znicholson17/P-Linked/ESP32_S3_ETH/README.md

# ESP32-S3 Ethernet PCB

The ESP32_S3_ETH KiCad project is a ESP32-S3 based PCB with built in Ethernet.  
The PCB has base features of a base ESP32-S3 Development board but with additional features.  

## Revision 1.0:

### Features
- Built-in 5V and 3.3V test points
- Grounded mounting points
- Programmable over UART and USB
- Wireless and Wired Connectivity
- 2 Programmable RGB LEDs
- Built to same form factor as WisLink LX200V20 EVB

### Hardware
  - ESP32-S3-WROOM-1-N16R8
  - QFN28 USB to UART Bridge
  - WizNet W5500 Ethernet Controller
  - 25Mhz Crystal Oscillators

### PCB
The first image shows the overall layout of the PCB with fills hidden and for each corresponding 3D View image, there is a built PCB image shown below.  

#### Layout of PCB
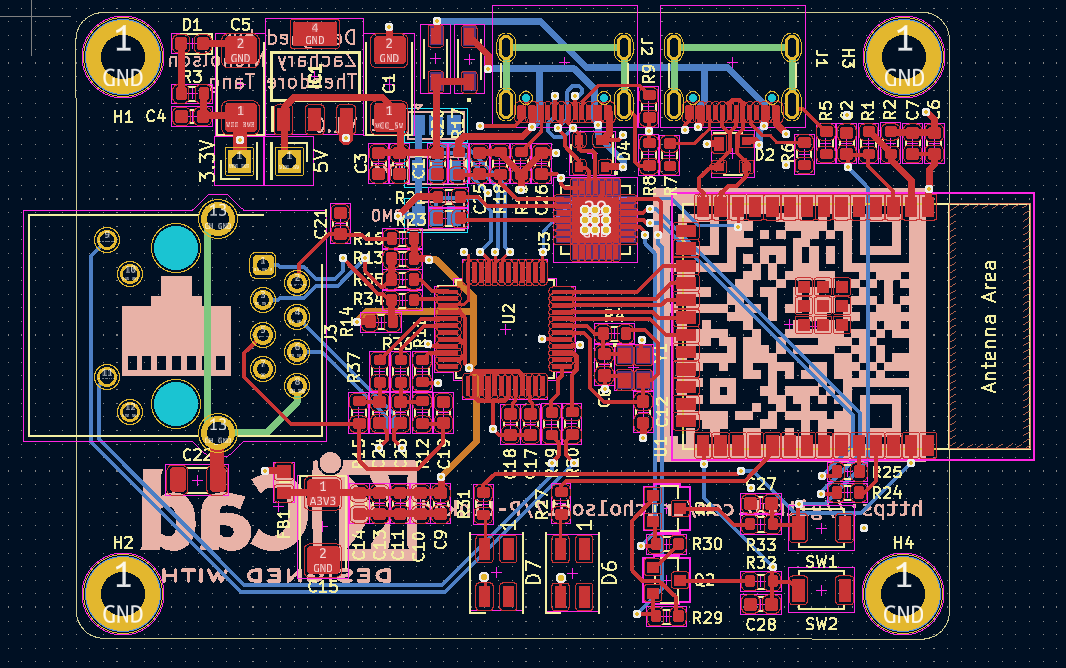
[picture p2: Docs/Images/ESP32-S3_ETH_LAYOUT.png]
  

#### Front of PCB

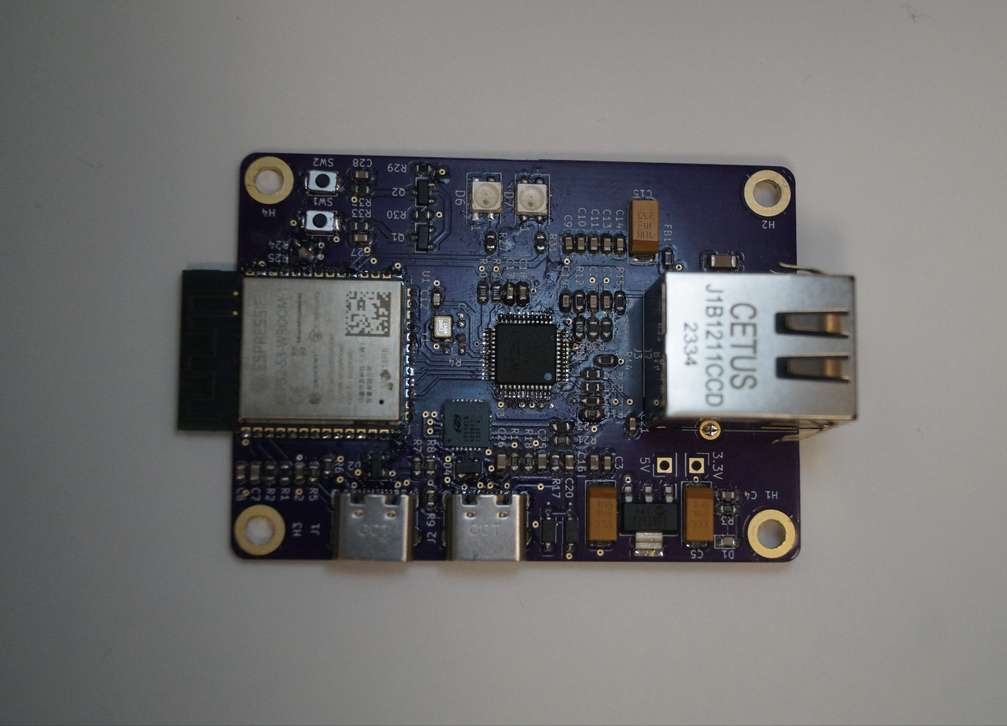
[picture p3: Docs/Images/ESP32-S3_ETH_FRONT.png]

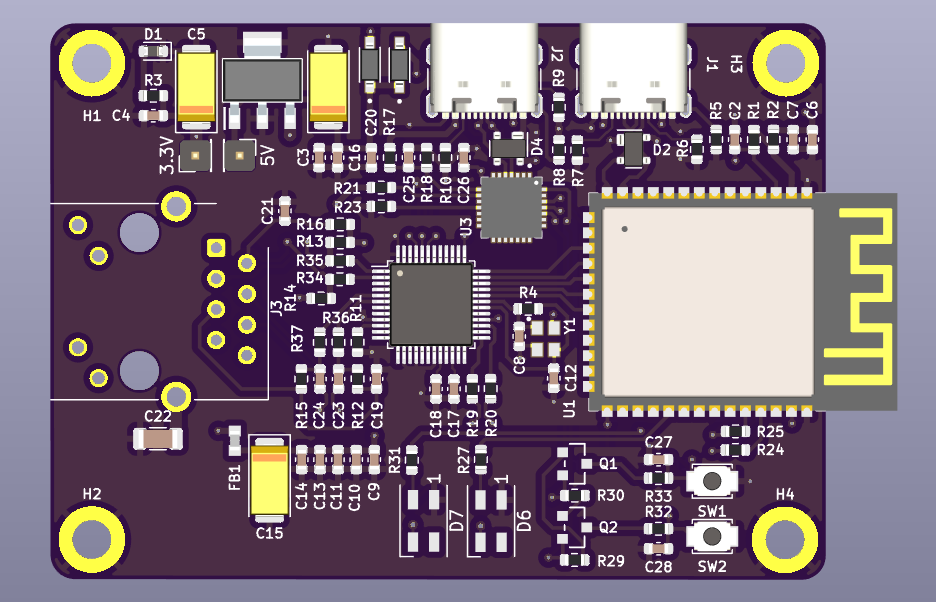
[picture p4: Docs/Images/ESP32-S3_ETH__3D_FRONT.png]


#### Back of PCB

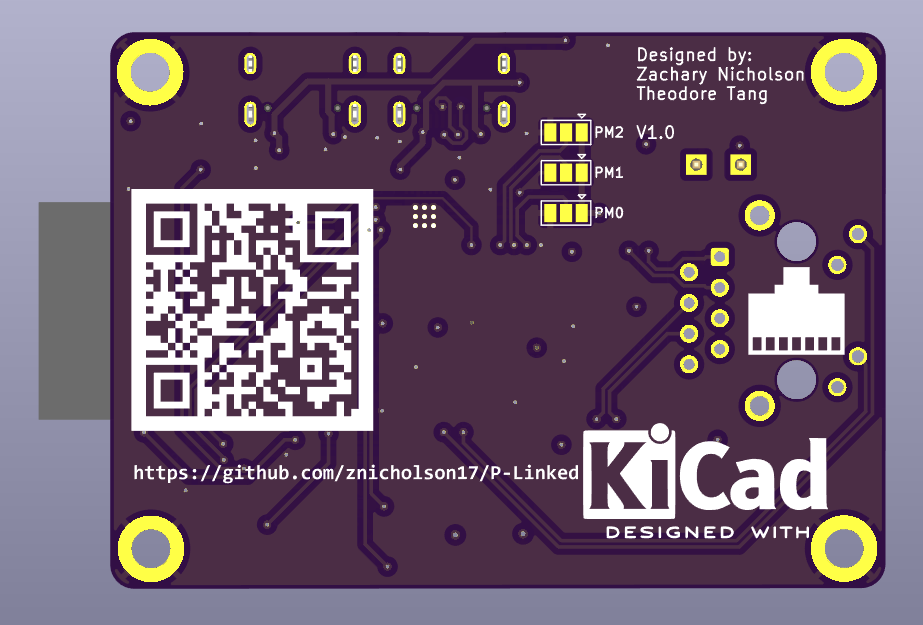
[picture p5: Docs/Images/ESP32-S3_ETH__3D_BACK.png]


## Future Revision

### Features:
- Increased Connction speeds
- Powered Over Ethernet
- Configerable MAC Address
- Built-in Header Pins for plug-and-play device board stack
