znicholson17/P-Linked/Docs/Images/ESP32-S3_ETH_NODE.png

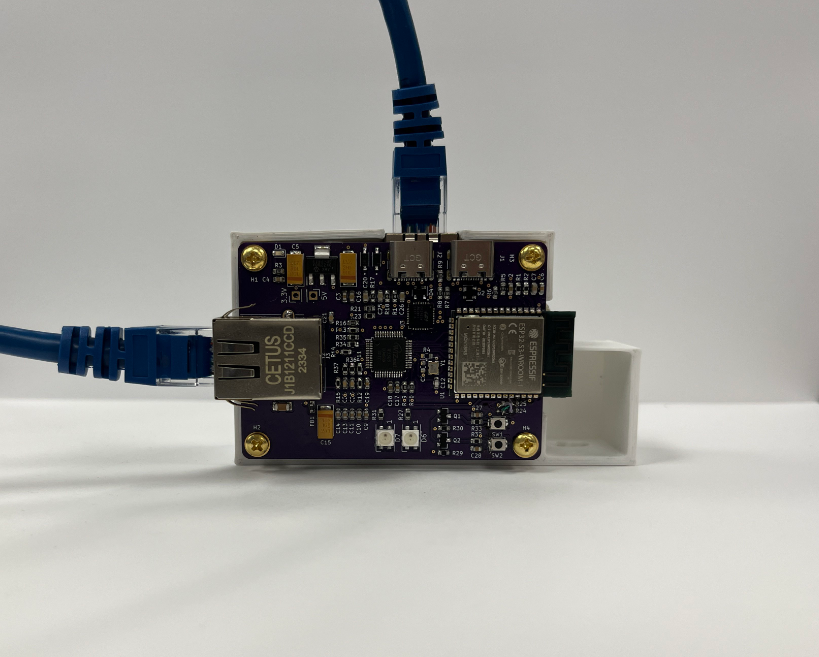
Docs/Images/ESP32-S3_ETH_NODE.png
