znicholson17/P-Linked/Docs/Images/P-LINKED_DIAGRAM.png

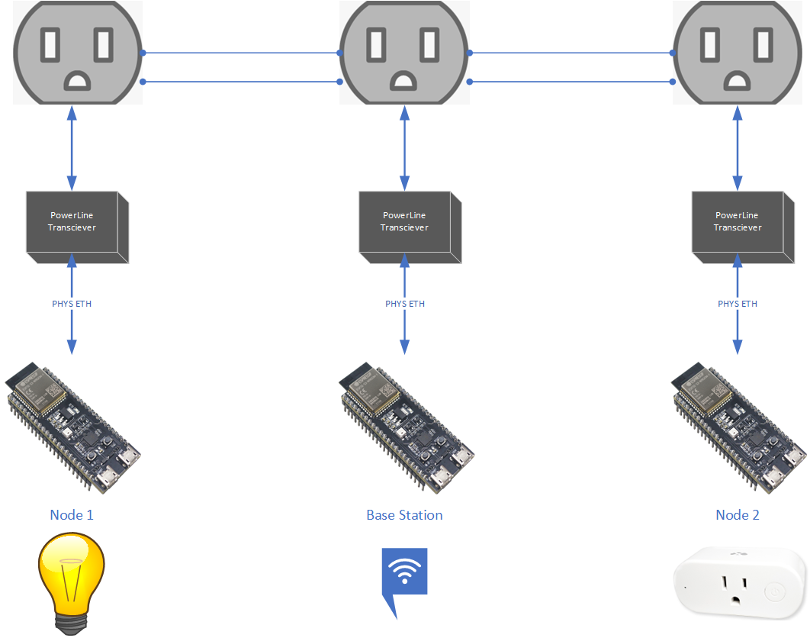
Docs/Images/P-LINKED_DIAGRAM.png
