znicholson17/P-Linked/ESP32_S3_ETH/Kicad_Libs/1N5819HW-7-F/1N5819HW-7-F.step

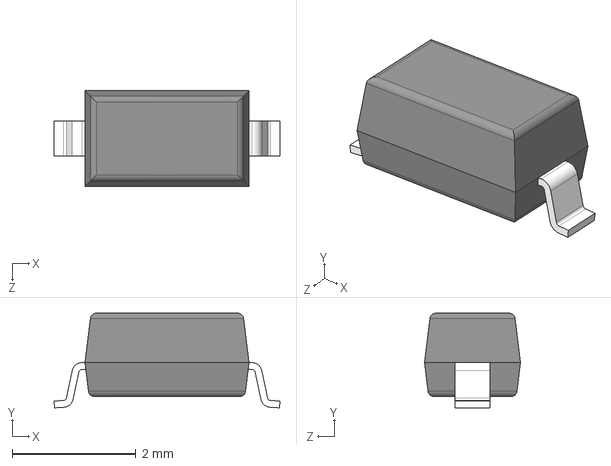
[picture p9: CAD file, 2024-02-09]
ESP32_S3_ETH/Kicad_Libs/1N5819HW-7-F/1N5819HW-7-F.step
3.65 x 1.53 x 1.55 mm
