znicholson17/P-Linked/ESP32_S3_ETH/Kicad_Libs/BK0603LL121-T/BK0603LL121-T.step

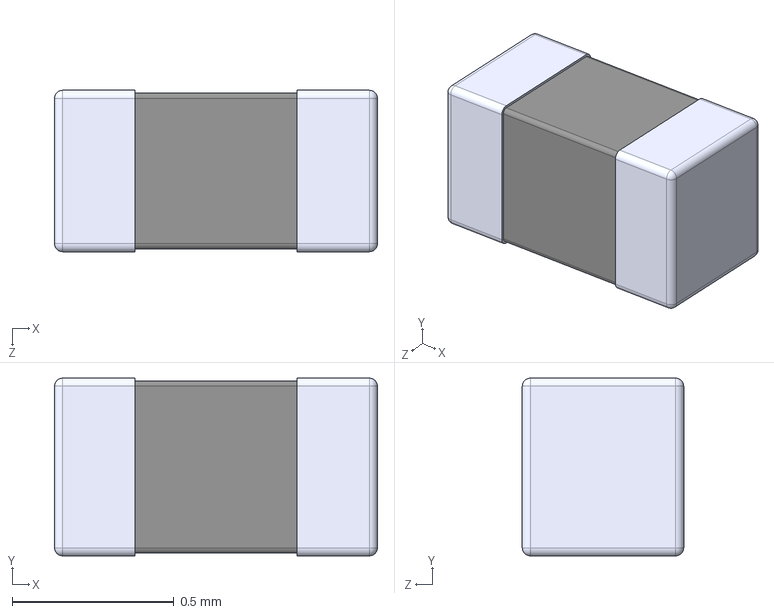
[picture p10: CAD file, 2024-02-09]
ESP32_S3_ETH/Kicad_Libs/BK0603LL121-T/BK0603LL121-T.step
1.00 x 0.55 x 0.5 mm
