znicholson17/P-Linked/ESP32_S3_ETH/Kicad_Libs/Conn_WIZnet_J1B1211CCD/eec.models/WIZnet_-_J1B1211CCD.step

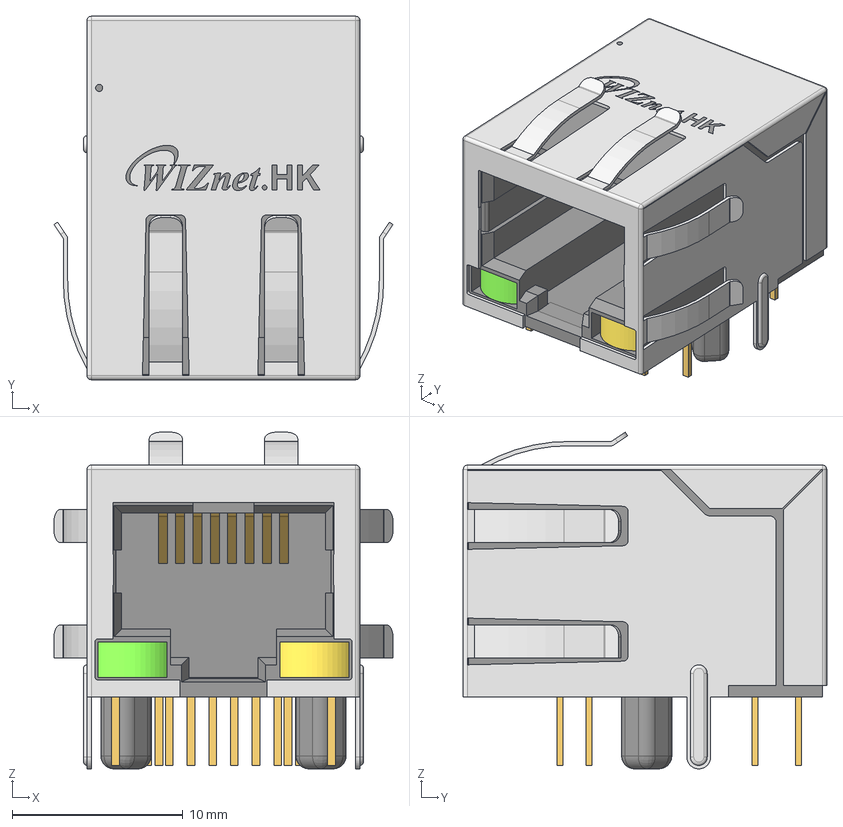
[picture p11: CAD file, 2024-02-09]
ESP32_S3_ETH/Kicad_Libs/Conn_WIZnet_J1B1211CCD/eec.models/WIZnet_-_J1B1211CCD.step
19.9 x 21.3 x 19.7 mm
logo
terminal
yellow led
green led
