znicholson17/P-Linked/ESP32_S3_ETH/Kicad_Libs/CP2102N-A02-GQFN28/CP2102N-A02-GQFN28.step

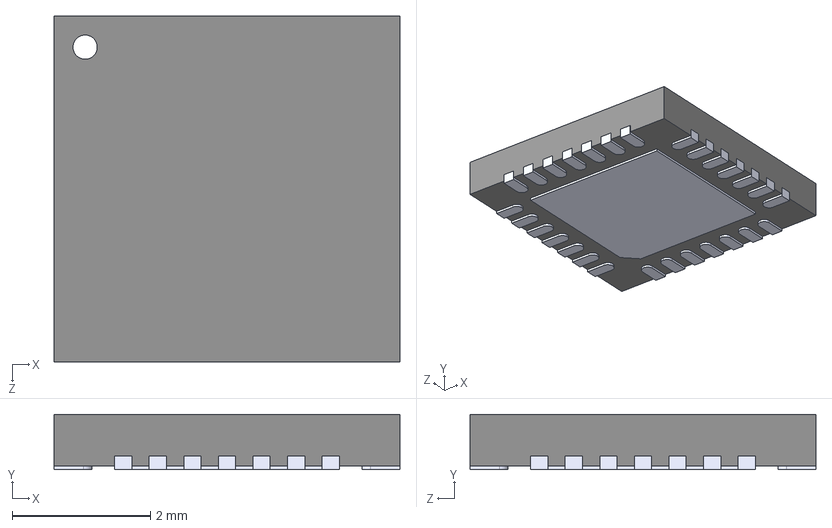
[picture p12: CAD file, 2024-02-06]
ESP32_S3_ETH/Kicad_Libs/CP2102N-A02-GQFN28/CP2102N-A02-GQFN28.step
5.00 x 0.8 x 5.00 mm
