znicholson17/P-Linked/ESP32_S3_ETH/Kicad_Libs/ECS-2033-250-BN-TR3/3D/ECS-2033-250-BN-TR3.stp

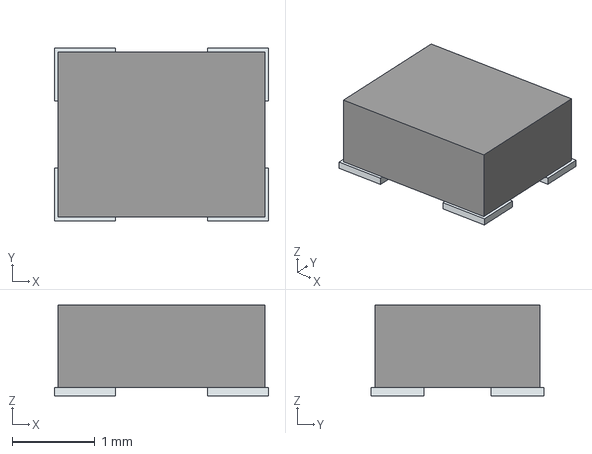
[picture p13: CAD file, 2024-02-12]
ESP32_S3_ETH/Kicad_Libs/ECS-2033-250-BN-TR3/3D/ECS-2033-250-BN-TR3.stp
2.59 x 2.09 x 1.10 mm
Pins
