znicholson17/P-Linked/ESP32_S3_ETH/Kicad_Libs/ESP32-S3-WROOM-1-N8R2/ESP32-S3-WROOM-1-N8R2.step

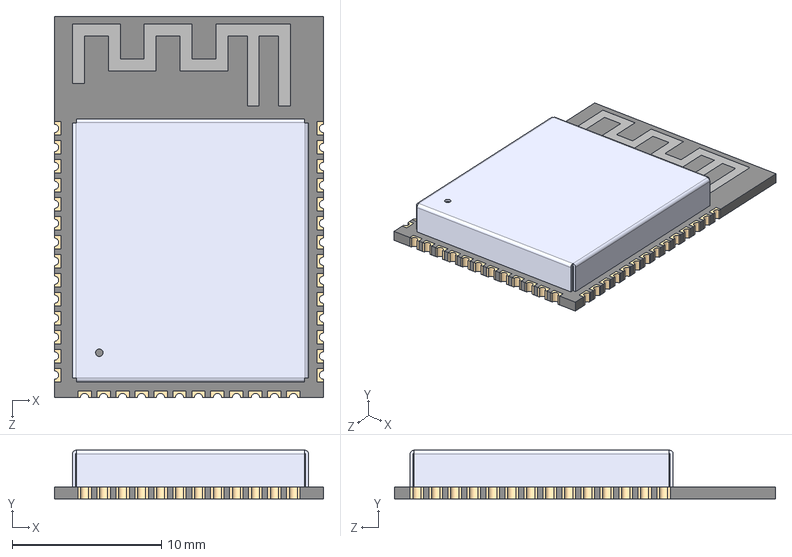
[picture p14: CAD file, 2024-02-09]
ESP32_S3_ETH/Kicad_Libs/ESP32-S3-WROOM-1-N8R2/ESP32-S3-WROOM-1-N8R2.step
18.0 x 3.25 x 25.5 mm
