znicholson17/P-Linked/ESP32_S3_ETH/Kicad_Libs/LIB_PE-0603PFB121ST/PE-0603PFB121ST/3D/PE-0603PFB121ST.stp

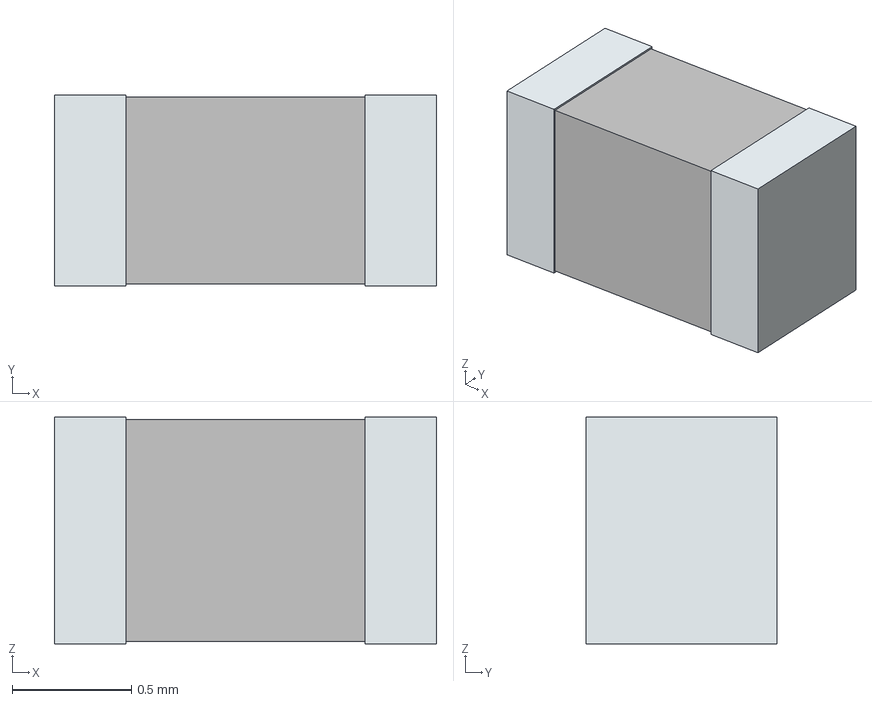
[picture p15: CAD file, 2024-02-12]
ESP32_S3_ETH/Kicad_Libs/LIB_PE-0603PFB121ST/PE-0603PFB121ST/3D/PE-0603PFB121ST.stp
1.60 x 0.8 x 0.95 mm
term1
term2
