znicholson17/P-Linked/ESP32_S3_ETH/Kicad_Libs/LIB_TC1264-3.3VDB/TC1264-3.3VDB/3D/TC1264-3.3VDB.stp

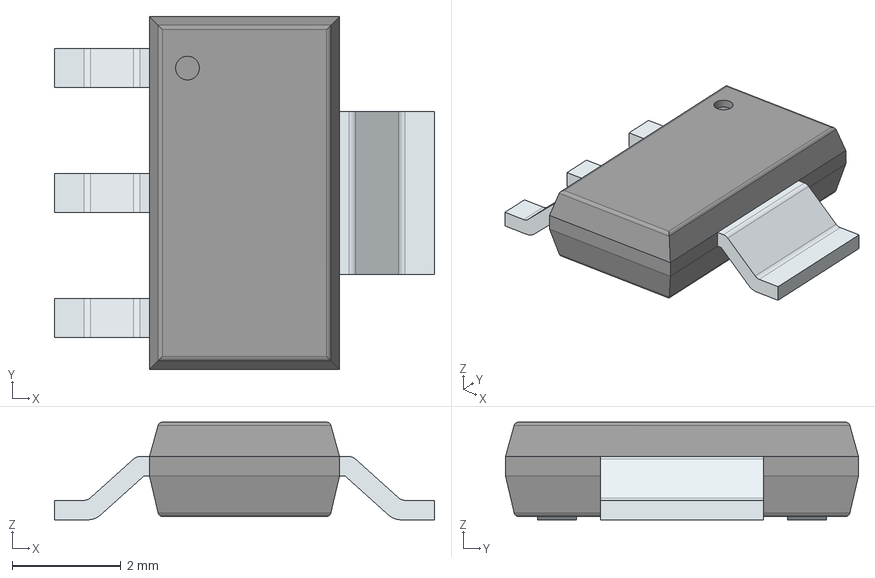
[picture p16: CAD file, 2024-02-12]
ESP32_S3_ETH/Kicad_Libs/LIB_TC1264-3.3VDB/TC1264-3.3VDB/3D/TC1264-3.3VDB.stp
7.00 x 6.50 x 1.80 mm
PinsArrayL
FilletPinR
