znicholson17/P-Linked/ESP32_S3_ETH/Kicad_Libs/SS8050-G/SS8050-G.step

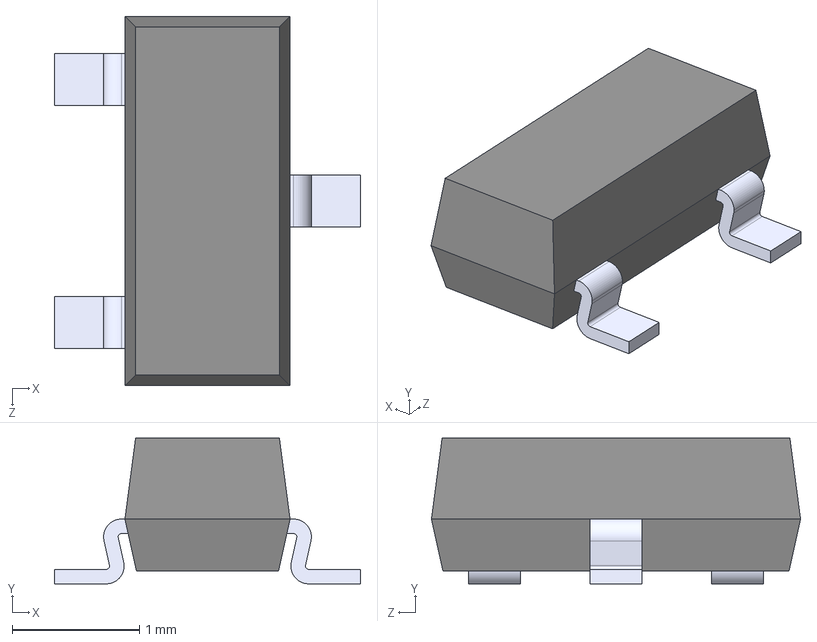
[picture p17: CAD file, 2024-02-09]
ESP32_S3_ETH/Kicad_Libs/SS8050-G/SS8050-G.step
2.40 x 1.14 x 2.90 mm
