znicholson17/P-Linked/ESP32_S3_ETH/Kicad_Libs/W5500/W5500.step

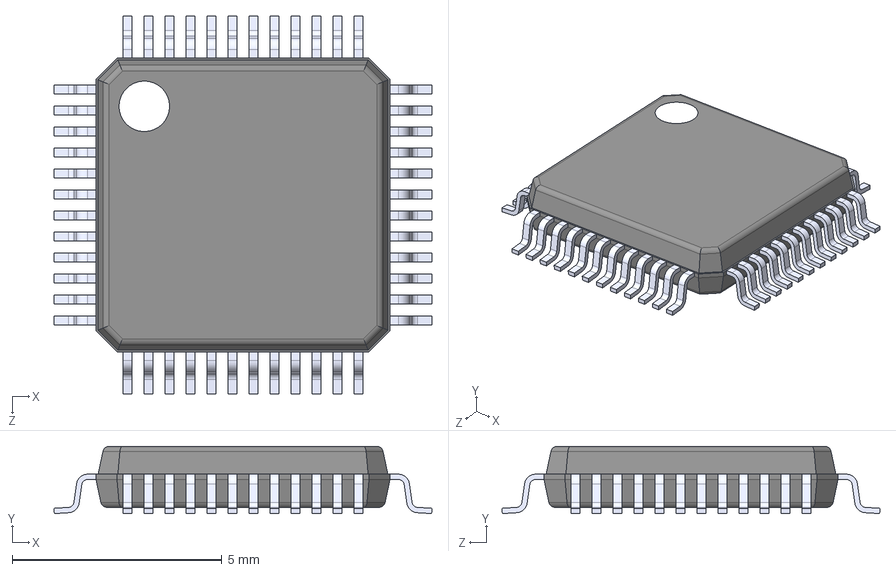
[picture p18: CAD file, 2024-02-09]
ESP32_S3_ETH/Kicad_Libs/W5500/W5500.step
9.00 x 1.60 x 9.00 mm
