znicholson17/P-Linked/(list of files, cad)

Other CAD files:
ESP32_S3_ETH/Kicad_Libs/ECS-2033-250-BN-TR3/Allegro/ecs2033250bntr3.psm
ESP32_S3_ETH/Kicad_Libs/ECS-2033-250-BN-TR3/DEHDL/ecs_2033_250_bn_tr3/chips/chips.prt
ESP32_S3_ETH/Kicad_Libs/LIB_PE-0603PFB121ST/PE-0603PFB121ST/Allegro/beadc1608x95n.psm
ESP32_S3_ETH/Kicad_Libs/LIB_PE-0603PFB121ST/PE-0603PFB121ST/DEHDL/pe_0603pfb121st/chips/chips.prt
ESP32_S3_ETH/Kicad_Libs/LIB_TC1264-3.3VDB/TC1264-3.3VDB/Allegro/sot230p700x180-4n.psm
ESP32_S3_ETH/Kicad_Libs/LIB_TC1264-3.3VDB/TC1264-3.3VDB/DEHDL/tc1264_3.3vdb/chips/chips.prt
