znicholson17/P-Linked/(list of files, drawings)

Other design files:
ESP32_S3_ETH/Kicad_Libs/ECS-2033-250-BN-TR3/Altium/ECS2033250BNTR3.PcbLib
ESP32_S3_ETH/Kicad_Libs/ECS-2033-250-BN-TR3/Altium/ECS-2033-250-BN-TR3.SchLib
ESP32_S3_ETH/Kicad_Libs/LIB_PE-0603PFB121ST/PE-0603PFB121ST/Altium/BEADC1608X95N.PcbLib
ESP32_S3_ETH/Kicad_Libs/LIB_PE-0603PFB121ST/PE-0603PFB121ST/Altium/PE-0603PFB121ST.SchLib
ESP32_S3_ETH/Kicad_Libs/LIB_TC1264-3.3VDB/TC1264-3.3VDB/Altium/SOT230P700X180-4N.PcbLib
ESP32_S3_ETH/Kicad_Libs/LIB_TC1264-3.3VDB/TC1264-3.3VDB/Altium/TC1264-3.3VDB.SchLib
