znicholson17/P-Linked/ESP32_S3_ETH/ESP32_S3_ETH.kicad_pcb

## KiCad design ESP32_S3_ETH/ESP32_S3_ETH.kicad_pcb (2024-02-17)

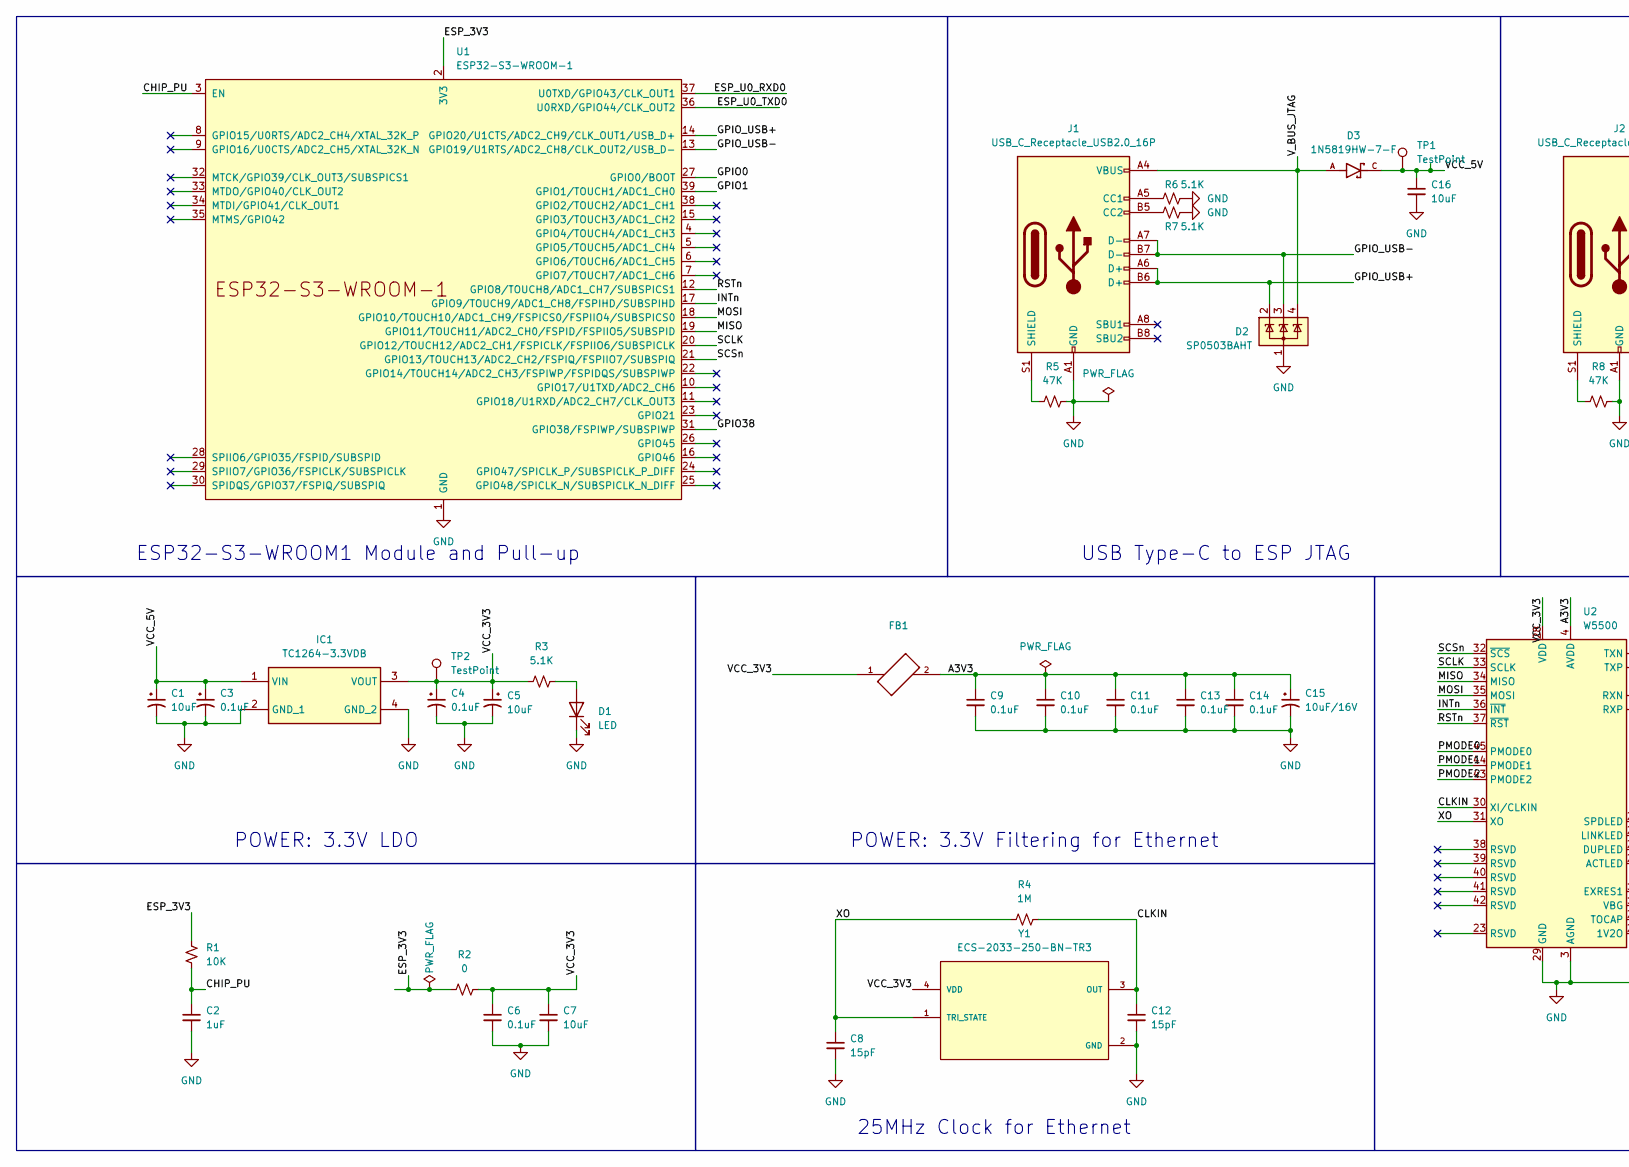
[picture p22: schematic ESP32_S3_ETH.kicad_sch, part in row 1, column 1]

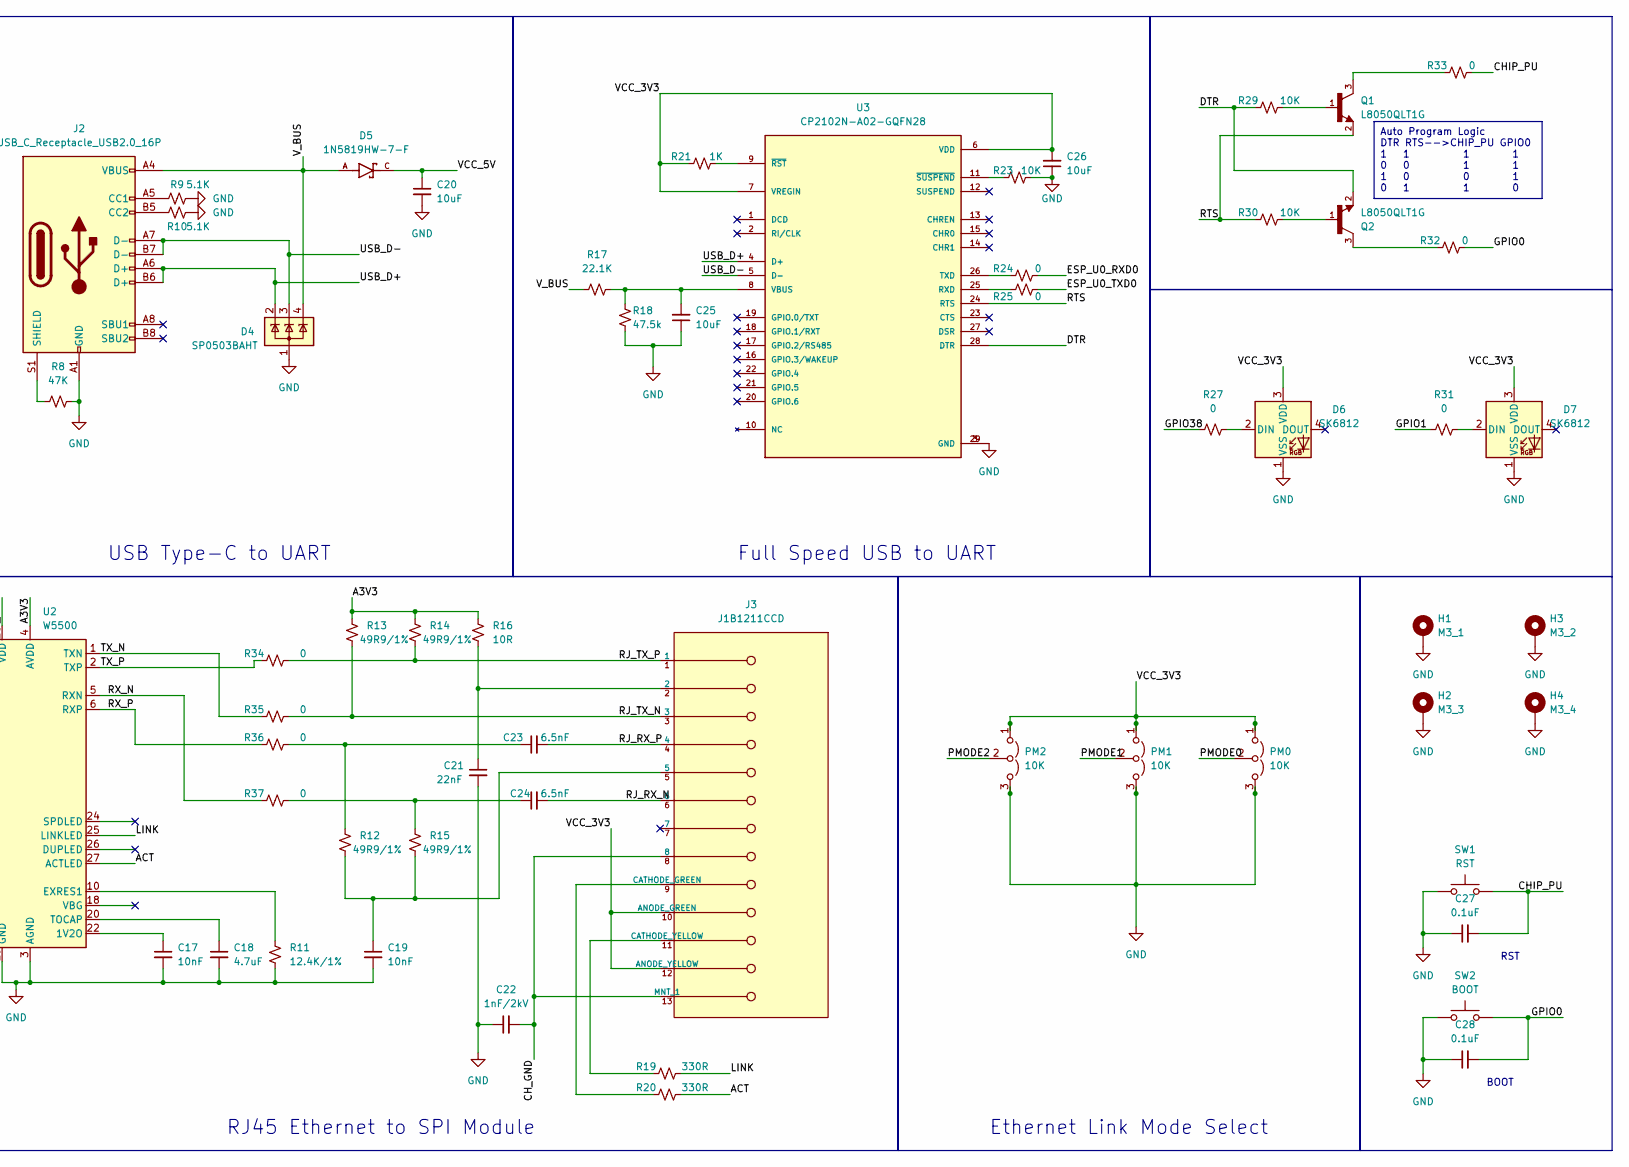
[picture p23: schematic ESP32_S3_ETH.kicad_sch, part in row 1, column 2]

Parts:
C1, C5: 10uF; CP_EIA-6032-28_Kemet-C
C2: 1uF; C_0603_1608Metric
C3, C4, C6, C9, C10, C11, C13, C14, C27, C28: 0.1uF; C_0603_1608Metric
C7, C16, C20, C25, C26: 10uF; C_0603_1608Metric
C8, C12: 15pF; C_0603_1608Metric
C15: 10uF/16V; CP_EIA-6032-28_Kemet-C
C17, C19: 10nF; C_0603_1608Metric
C18: 4.7uF; C_0603_1608Metric
C21: 22nF; C_0603_1608Metric
C22: 1nF/2kV; C_1206_3216Metric
C23, C24: 6.5nF; C_0603_1608Metric
D1: LED; D_0603_1608Metric
D2, D4: SP0503BAHT; SOT-143
D3, D5: 1N5819HW-7-F; SOD3715X145N; PARTREV 18-2
D6, D7: SK6812; LED_SK6812MINI_PLCC4_3.5x3.5mm_P1.75mm
FB1: BEADC1608X95N
H1: M3_1; MountingHole_3.2mm_M3_ISO14580_Pad
H2: M3_3; MountingHole_3.2mm_M3_ISO14580_Pad
H3: M3_2; MountingHole_3.2mm_M3_ISO14580_Pad
H4: M3_4; MountingHole_3.2mm_M3_ISO14580_Pad
IC1: TC1264-3.3VDB; SOT230P700X180-4N; Manufacturer_Part_Number TC1264-3.3VDB; Mouser Part Number 579-TC1264-3.3VDB
J1, J2: USB_C_Receptacle_USB2.0_16P; USB_C_Receptacle_GCT_USB4105-xx-A_16P_TopMnt_Horizontal
J3: J1B1211CCD; RJ45_Cetus_J1B1211CCD_Horizontal; mouser part number 950-J1B1211CCD; digikey description CONN JACK 1PORT 100 BASE-T PCB
PM0, PM1, PM2: 10K; SolderJumper-3_P1.3mm_Open_Pad1.0x1.5mm
Q1, Q2: L8050QLT1G; SOT-23_MCC; PARTREV A
R1, R23, R29, R30: 10K; R_0603_1608Metric
R2, R24, R25, R27, R31, R32, R33, R34, R35, R36, R37: 0; R_0603_1608Metric
R3, R6, R7, R9, R10: 5.1K; R_0603_1608Metric
R4: 1M; R_0603_1608Metric
R5, R8: 47K; R_0603_1608Metric
R11: 12.4K/1%; R_0603_1608Metric
R12, R13, R14, R15: 49R9/1%; R_0603_1608Metric
R16: 10R; R_0603_1608Metric
R17: 22.1K; R_0603_1608Metric
R18: 47.5k; R_0603_1608Metric
R19, R20: 330R; R_0603_1608Metric
R21: 1K; R_0603_1608Metric
SW1: RST; SW_SPST_B3U-1000P
SW2: BOOT; SW_SPST_B3U-1000P
TP1, TP2: TestPoint; PinHeader_1x01_P2.54mm_Vertical
U1: ESP32-S3-WROOM-1
U2: W5500; LQFP-48_7x7mm_P0.5mm
U3: CP2102N-A02-GQFN28; QFN50P500X500X80-29N; PARTREV 1.5
Y1: ECS-2033-250-BN-TR3; OSC_ECS-2033-250-BN-TR3; PARTREV 11/15/13

Connections:
/A3V3: C9.1, C10.1, C11.1, C13.1, C14.1, C15.1, FB1.2, R13.1, R14.1, R16.1, U2.4 (AVDD), U2.8 (AVDD), U2.11 (AVDD), U2.15 (AVDD), U2.17 (AVDD), U2.21 (AVDD)
/ACT: R20.2, U2.27 (ACTLED)
/CHIP_PU: C2.1, C27.2, R1.2, R33.1, SW1.2, U1.3 (EN)
/CH_GND: C22.2, J3.8, J3.13 (MNT_1)
/CLKIN: C12.1, R4.2, U2.30 (XI/CLKIN), Y1.3 (OUT)
/DTR: Q2.2, R29.2, U3.28 (DTR)
/ESP_3V3: R1.1, R2.1, U1.2 (3V3)
/ESP_U0_RXD0: R24.2, U1.37 (U0TXD/GPIO43/CLK_OUT1)
/ESP_U0_TXD0: R25.2, U1.36 (U0RXD/GPIO44/CLK_OUT2)
/GPIO0: C28.2, R32.1, SW2.2, U1.27 (GPIO0/BOOT)
/GPIO1: R31.1, U1.39 (GPIO1/TOUCH1/ADC1_CH0)
/GPIO38: R27.1, U1.31 (GPIO38/FSPIWP/SUBSPIWP)
/GPIO_USB+: D2.2 (K), J1.A6 (D+), J1.B6 (D+), U1.14 (GPIO20/U1CTS/ADC2_CH9/CLK_OUT1/USB_D+)
/GPIO_USB-: D2.3 (K), J1.A7 (D-), J1.B7 (D-), U1.13 (GPIO19/U1RTS/ADC2_CH8/CLK_OUT2/USB_D-)
/INTn: U1.17 (GPIO9/TOUCH9/ADC1_CH8/FSPIHD/SUBSPIHD), U2.36 (~INT)
/LINK: R19.2, U2.25 (LINKLED)
/MISO: U1.19 (GPIO11/TOUCH11/ADC2_CH0/FSPID/FSPIIO5/S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), U2.34 (MISO)
/MOSI: U1.18 (GPIO10/TOUCH10/ADC1_CH9/FSPICS0/FSPIIO4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), U2.35 (MOSI)
/PMODE0: PM0.2 (C), U2.45 (PMODE0)
/PMODE1: PM1.2 (C), U2.44 (PMODE1)
/PMODE2: PM2.2 (C), U2.43 (PMODE2)
/RJ_RX_N: C24.2, J3.6
/RJ_RX_P: C23.2, J3.4
/RJ_TX_N: J3.3, R13.2, R35.2
/RJ_TX_P: J3.1, R14.2, R34.2
/RSTn: U1.12 (GPIO8/TOUCH8/ADC1_CH7/SUBSPICS1), U2.37 (~RST)
/RTS: Q1.2, R30.2, U3.24 (RTS)
/RX_N: R37.1, U2.5 (RXN)
/RX_P: R36.1, U2.6 (RXP)
/SCLK: U1.20 (GPIO12/TOUCH12/ADC2_CH1/FSPICLK/FSPIIO6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), U2.33 (SCLK)
/SCSn: U1.21 (GPIO13/TOUCH13/ADC2_CH2/FSPIQ/FSPIIO7/S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), U2.32 (~SCS)
/TX_N: R35.1, U2.1 (TXN)
/TX_P: R34.1, U2.2 (TXP)
/USB_D+: D4.2 (K), J2.A6 (D+), J2.B6 (D+), U3.4 (D+)
/USB_D-: D4.3 (K), J2.A7 (D-), J2.B7 (D-), U3.5 (D-)
/VCC_3V3: C4.1, C5.1, C6.1, C7.1, C26.2, D6.3 (VDD), D7.3 (VDD), FB1.1, IC1.3 (VOUT), J3.10 (ANODE_GREEN), J3.12 (ANODE_YELLOW), PM0.1 (A), PM1.1 (A), PM2.1 (A), R2.2, R3.1, R21.2, TP2.1, U2.28 (VDD), U3.6 (VDD), U3.7 (VREGIN), Y1.4 (VDD); also elsewhere on the board
/VCC_5V: C1.1, C3.1, C16.1, C20.1, D3.C, D5.C, IC1.1 (VIN), TP1.1; also elsewhere on the board
/V_BUS: D4.4 (K), D5.A, J2.A4 (VBUS), J2.A9 (VBUS), J2.B4 (VBUS), J2.B9 (VBUS), R17.1
/V_BUS_JTAG: D2.4 (K), D3.A, J1.A4 (VBUS), J1.A9 (VBUS), J1.B4 (VBUS), J1.B9 (VBUS)
/XO: C8.1, R4.1, U2.31 (XO), Y1.1 (TRI_STATE)
GND: C1.2, C2.2, C3.2, C4.2, C5.2, C6.2, C7.2, C8.2, C9.2, C10.2, C11.2, C12.2, C13.2, C14.2, C15.2, C16.2, C17.2, C18.2, C19.2, C20.2, C21.2, C22.1, C25.1, C26.1, C27.1, C28.1, D1.1 (K), D2.1 (A), D4.1 (A), D6.1 (VSS), D7.1 (VSS), H1.1, H2.1, H3.1, H4.1, IC1.2 (GND_1), IC1.4 (GND_2), J1.A1 (GND), J1.A12 (GND), J1.B1 (GND), J1.B12 (GND), J2.A1 (GND), J2.A12 (GND), J2.B1 (GND), J2.B12 (GND), PM0.3 (B), PM1.3 (B), PM2.3 (B), R5.1, R6.2, R7.2, R8.1, R9.2, R10.2, R11.2, R18.1, R23.1, SW1.1, SW2.1, U1.1 (GND), U1.40 (GND), U1.41 (GND), U2.3 (AGND), U2.9 (AGND), U2.14 (AGND), U2.16 (AGND), U2.19 (AGND), U2.29 (GND), U2.48 (AGND), U3.3 (GND), U3.29 (GND), Y1.2 (GND)
unnamed: C19.1, J3.5, R12.2, R15.2
unnamed: C21.1, J3.2, R16.2
unnamed: C23.1, R12.1, R36.2
unnamed: C24.1, R15.1, R37.2
unnamed: D1.2 (A), R3.2
unnamed: D6.2 (DIN), R27.2
unnamed: D7.2 (DIN), R31.2
unnamed: J1.A5 (CC1), R6.1
unnamed: J1.B5 (CC2), R7.1
unnamed: J1.S1 (SHIELD), R5.2
unnamed: J2.A5 (CC1), R9.1
unnamed: J2.B5 (CC2), R10.1
unnamed: J2.S1 (SHIELD), R8.2
unnamed: J3.9 (CATHODE_GREEN), R20.1
unnamed: J3.11 (CATHODE_YELLOW), R19.1
unnamed: Q1.1, R29.1
unnamed: Q1.3, R33.2
unnamed: Q2.1, R30.1
unnamed: Q2.3, R32.2
unnamed: C17.1, U2.22 (1V2O)
unnamed: R11.1, U2.10 (EXRES1)
unnamed: C18.1, U2.20 (TOCAP)
unnamed: R25.1, U3.25 (RXD)
unnamed: R24.1, U3.26 (TXD)
unnamed: C25.2, R17.2, R18.2, U3.8 (VBUS)
unnamed: R21.1, U3.9 (~RST)
unnamed: R23.2, U3.11 (~SUSPEND)

Notes on the sheet:
Auto Program Logic DTR RTS-->CHIP_PU GPIO0 1 1 1 1 0 0 1 1 1 0 0 1 0 1 1 0
USB Type-C to ESP JTAG
BOOT
USB Type-C to UART
RJ45 Ethernet to SPI Module
POWER: 3.3V LDO
Full Speed USB to UART
Ethernet Link Mode Select
POWER: 3.3V Filtering for Ethernet
25MHz Clock for Ethernet
RST
ESP32-S3-WROOM1 Module and Pull-up

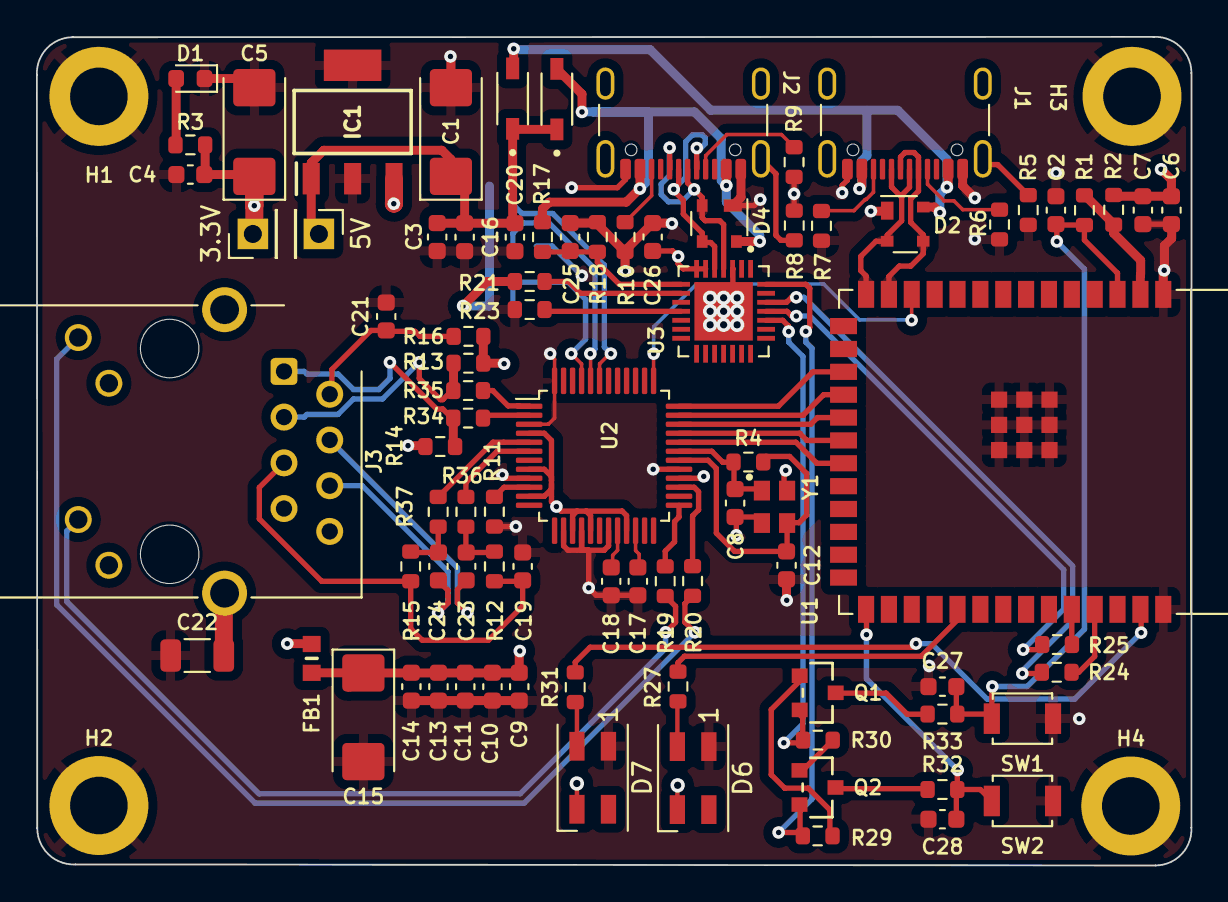
[picture p24: board ESP32_S3_ETH.kicad_pcb from above]

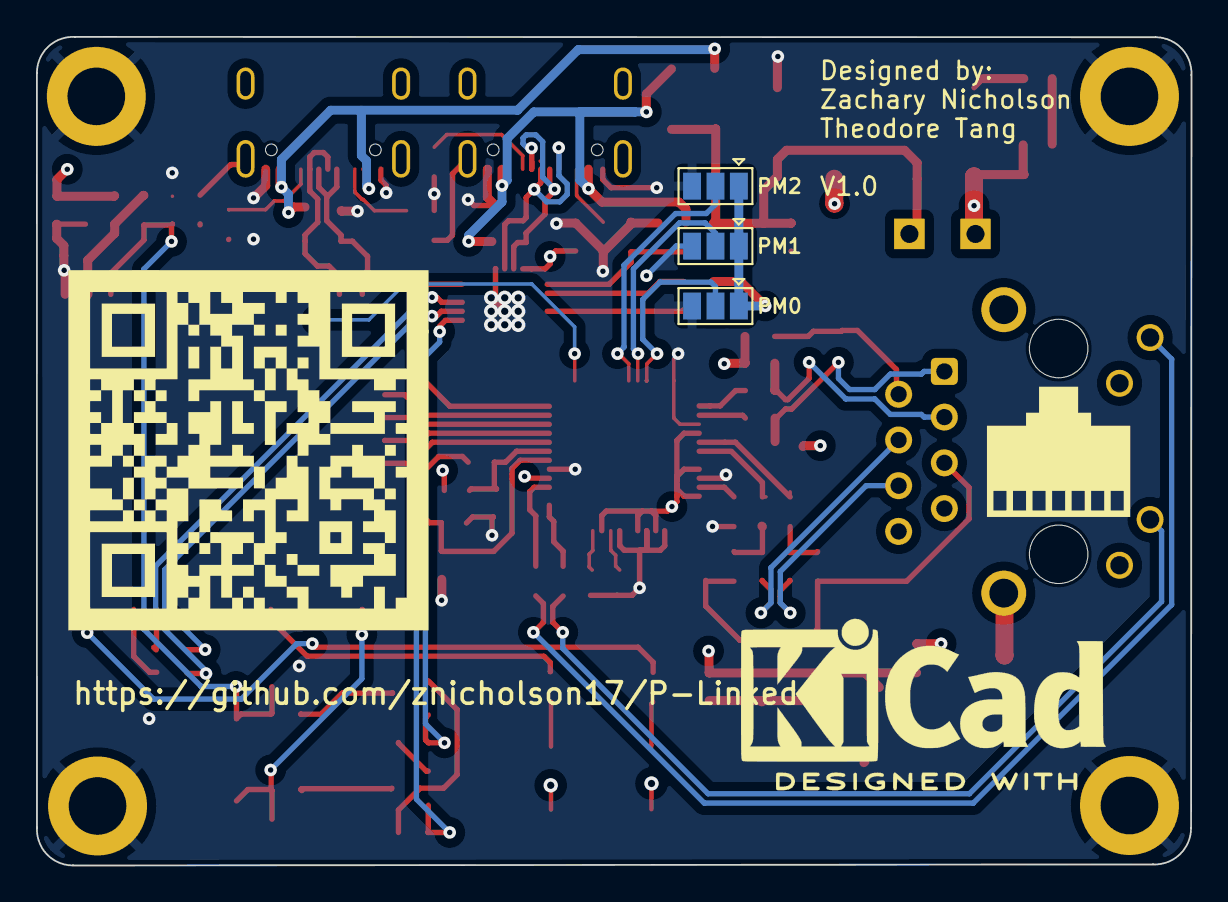
[picture p25: board ESP32_S3_ETH.kicad_pcb from below]

Board: 4 copper layers, 64.1 x 46.0 mm, 91 parts (3 on the bottom side), 68 nets.

Other parts of the board:
3.3V, 5V: TestPoint; PinHeader_1x01_P2.54mm_Vertical

Their connections:
/VCC_3V3: 3.3V.1; also elsewhere on the board
/VCC_5V: 5V.1; also elsewhere on the board
