znicholson17/P-Linked/nodes/thermostat/main/main.c

#include "freertos/FreeRTOS.h"
#include "freertos/task.h"
#include "driver/gpio.h"
#include "driver/i2c.h"
#include "esp_err.h"
#include "esp_log.h"
#include "wifi.h"
#include "lwip/sockets.h"

#include "sdkconfig.h"
#include "bme280.h"
#include <string.h>

#define pdSECOND pdMS_TO_TICKS(1000)
#define SDA_PIN 8
#define SCL_PIN 9

#define TAG_BME280 "BME280"
#define TAG_SOCK "SOCK_CLIENT" 

#define I2C_MASTER_ACK 0
#define I2C_MASTER_NACK 1

static const char *SERVER_IP = "192.168.1.141";
static const int SERVER_PORT = 12345;

void i2c_master_init()
{
	i2c_config_t i2c_config = {
		.mode = I2C_MODE_MASTER,
		.sda_io_num = SDA_PIN,
		.scl_io_num = SCL_PIN,
		.sda_pullup_en = GPIO_PULLUP_ENABLE,
		.scl_pullup_en = GPIO_PULLUP_ENABLE,
		.master.clk_speed = 1000000
	};
	i2c_param_config(I2C_NUM_0, &i2c_config);
	i2c_driver_install(I2C_NUM_0, I2C_MODE_MASTER, 0, 0, 0);
}

s8 BME280_I2C_bus_write(u8 dev_addr, u8 reg_addr, u8 *reg_data, u8 cnt)
{
	s32 iError = BME280_INIT_VALUE;

	esp_err_t espRc;
	i2c_cmd_handle_t cmd = i2c_cmd_link_create();

	i2c_master_start(cmd);
	i2c_master_write_byte(cmd, (dev_addr << 1) | I2C_MASTER_WRITE, true);

	i2c_master_write_byte(cmd, reg_addr, true);
	i2c_master_write(cmd, reg_data, cnt, true);
	i2c_master_stop(cmd);

	espRc = i2c_master_cmd_begin(I2C_NUM_0, cmd, 10/portTICK_PERIOD_MS);
	if (espRc == ESP_OK) {
		iError = SUCCESS;
	} else {
		iError = ERROR;
	}
	i2c_cmd_link_delete(cmd);

	return (s8)iError;
}

s8 BME280_I2C_bus_read(u8 dev_addr, u8 reg_addr, u8 *reg_data, u8 cnt)
{
	s32 iError = BME280_INIT_VALUE;
	esp_err_t espRc;

	i2c_cmd_handle_t cmd = i2c_cmd_link_create();

	i2c_master_start(cmd);
	i2c_master_write_byte(cmd, (dev_addr << 1) | I2C_MASTER_WRITE, true);
	i2c_master_write_byte(cmd, reg_addr, true);

	i2c_master_start(cmd);
	i2c_master_write_byte(cmd, (dev_addr << 1) | I2C_MASTER_READ, true);

	if (cnt > 1) {
		i2c_master_read(cmd, reg_data, cnt-1, I2C_MASTER_ACK);
	}
	i2c_master_read_byte(cmd, reg_data+cnt-1, I2C_MASTER_NACK);
	i2c_master_stop(cmd);

	espRc = i2c_master_cmd_begin(I2C_NUM_0, cmd, 10/portTICK_PERIOD_MS);
	if (espRc == ESP_OK) {
		iError = SUCCESS;
	} else {
		iError = ERROR;
	}

	i2c_cmd_link_delete(cmd);

	return (s8)iError;
}

void BME280_delay_msek(u32 msek)
{
	vTaskDelay(msek/portTICK_PERIOD_MS);
}

void bme280_reader_task(void *ignore, int socket)
{
	struct bme280_t bme280 = {
		.bus_write = BME280_I2C_bus_write,
		.bus_read = BME280_I2C_bus_read,
		.dev_addr = BME280_I2C_ADDRESS1,
		.delay_msec = BME280_delay_msek
	};

	s32 com_rslt;
	s32 v_uncomp_pressure_s32;
	s32 v_uncomp_temperature_s32;
	s32 v_uncomp_humidity_s32;

	com_rslt = bme280_init(&bme280);

	com_rslt += bme280_set_oversamp_pressure(BME280_OVERSAMP_16X);
	com_rslt += bme280_set_oversamp_temperature(BME280_OVERSAMP_2X);
	com_rslt += bme280_set_oversamp_humidity(BME280_OVERSAMP_1X);

	com_rslt += bme280_set_standby_durn(BME280_STANDBY_TIME_1_MS);
	com_rslt += bme280_set_filter(BME280_FILTER_COEFF_16);

	com_rslt += bme280_set_power_mode(BME280_NORMAL_MODE);
	if (com_rslt == SUCCESS) {
		//while(true) {
			vTaskDelay(40/portTICK_PERIOD_MS);

			com_rslt = bme280_read_uncomp_pressure_temperature_humidity(
				&v_uncomp_pressure_s32, &v_uncomp_temperature_s32, &v_uncomp_humidity_s32);

			if (com_rslt == SUCCESS) {
				ESP_LOGI(TAG_BME280, "%.2f degC / %.3f hPa / %.3f %%",
					bme280_compensate_temperature_double(v_uncomp_temperature_s32),
					bme280_compensate_pressure_double(v_uncomp_pressure_s32)/100, // Pa -> hPa
					bme280_compensate_humidity_double(v_uncomp_humidity_s32));
                char sensor_data[128];
                snprintf(sensor_data, sizeof(sensor_data), "%.2f degC / %.3f hPa / %.3f %%",
					bme280_compensate_temperature_double(v_uncomp_temperature_s32),
					bme280_compensate_pressure_double(v_uncomp_pressure_s32)/100, // Pa -> hPa
					bme280_compensate_humidity_double(v_uncomp_humidity_s32));
                int data_len = strlen(sensor_data);
                int bytes_sent = send(socket, sensor_data, data_len, 0);
                if(bytes_sent > 0){
                    ESP_LOGI(TAG_BME280, "Sent sensor data: %s", sensor_data);
                }else {
                    ESP_LOGE(TAG_BME280, "Failed to send sensor data.");
                }

			} else {
				ESP_LOGE(TAG_BME280, "measure error. code: %d", com_rslt);
			}
	} else {
		ESP_LOGE(TAG_BME280, "init or setting error. code: %d", com_rslt);
	}

	//vTaskDelete(NULL);
}






void socket_client_task(void *pvParameters) {
    struct sockaddr_in server_addr;
    int client_socket;

    // Create socket
    client_socket = socket(AF_INET, SOCK_STREAM, 0);
    if (client_socket < 0) {
        ESP_LOGE(TAG_SOCK, "Failed to create socket");
        vTaskDelete(NULL);
        return;
    }

    server_addr.sin_family = AF_INET;
    server_addr.sin_port = htons(SERVER_PORT);
    server_addr.sin_addr.s_addr = inet_addr(SERVER_IP);

    // Connect to the server
    if (connect(client_socket, (struct sockaddr *)&server_addr, sizeof(server_addr)) < 0) {
        ESP_LOGE(TAG_SOCK, "Failed to connect to server");
        close(client_socket);
        vTaskDelete(NULL);
        return;
    }

    while (1) {
        bme280_reader_task(NULL, client_socket);
        vTaskDelay(pdMS_TO_TICKS(5000));  // Send sensor data every 5 seconds
    }

    close(client_socket);
    vTaskDelete(NULL);
}



static const char* TAG = "Main";
void app_main() {
    esp_log_level_set(TAG, ESP_LOG_INFO);
    
    
    wifi_begin();
    //socket_server_init();
    //socket_server_start();
/*
    while (1) {
        // Your main application code can go here
        //
        vTaskDelay(pdSECOND * 2);
    }
*/  
    i2c_master_init();
    xTaskCreate(&socket_client_task, "socket_client_task", 4096, NULL, 6, NULL);
    // xTaskCreate(&bme280_reader_task, "bme280_reader_task", 2048, NULL, 6,                 NULL);
}
    
