znicholson17/P-Linked/(commit log)

2023-10-23 Further development on hub, socket communication, and a proof of concept thermostat node
2024-01-29 Initialized node examples and including an alpha version of the custom connectedhomeip ethernet driver
    [partitions.csv, partitions_example.csv]
2024-02-06 Custom PCB Files
    [CP2102N-A02-GQFN28.step, ESP32-PLC.kicad_pcb, ESP32-PLC.kicad_sch, TPSM84205EAB.step]
2024-02-09 Ethernet PCB Schematic completed. Light node switched to newer version of ESP-Matter
    [1N5819HW-7-F.step, BK0603LL121-T.step, CP2102N-A02-GQFN28.step, ESP32-PLC.csv, ESP32-S3-WROOM-1-N8R2.step, ESP32_S3_ETH.kicad_pcb, ESP32_S3_ETH.kicad_sch, SS8050-G.step]
2024-02-12 ESP_ETH Schematic Finished, Routing Started on PCB
    [BEADC1608X95N.PcbLib, ECS-2033-250-BN-TR3.SchLib, ECS-2033-250-BN-TR3.stp, ECS2033250BNTR3.PcbLib, EDI2CAP.CFG, ESP32_S3_ETH.kicad_pcb, ESP32_S3_ETH.kicad_sch, PE-0603PFB121ST.SchLib]
2024-02-14 Initial commit of the routing for the ethernet PCB for review and correction.
    [ESP32_S3_ETH.kicad_pcb, ESP32_S3_ETH.kicad_sch]
2024-02-16 Routing of Ethernet PCB completed, Pending further verification before finalized.
    [ESP32_S3_ETH.kicad_pcb, ESP32_S3_ETH.kicad_sch]
2024-02-17 Ethernet PCB finalized and ordered, hardware construction pending arrival.
    [ESP32_S3_ETH.kicad_pcb, ESP32_S3_ETH.kicad_sch]
2024-03-15 Added for Ethernet Driver
2024-03-15 Added KiCad Images
