znicholson17/P-Linked/nodes/ethernet/ethernet_perf_node.jpg

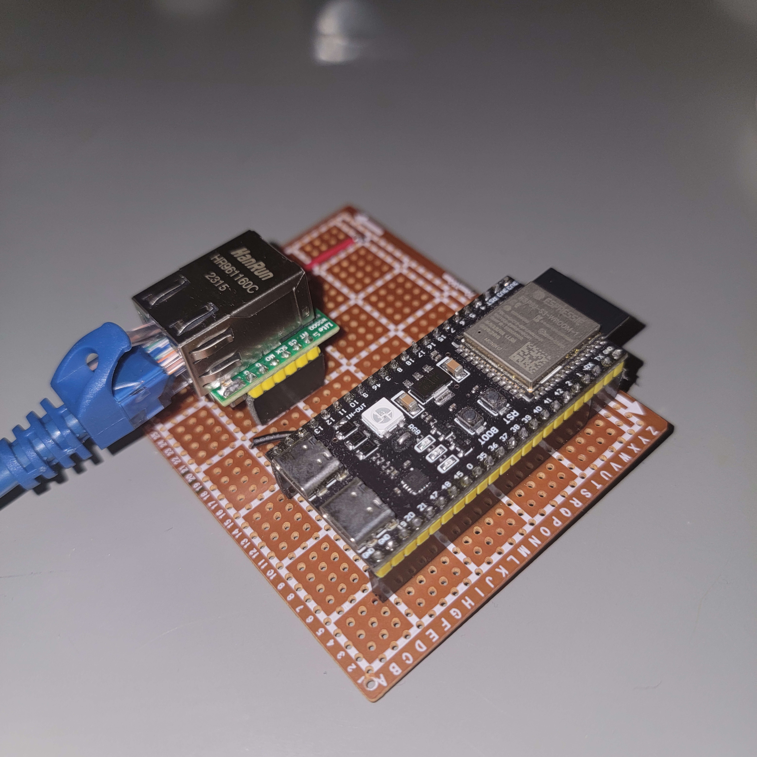
nodes/ethernet/ethernet_perf_node.jpg
